MDU-C2/Butler/report/title.tex

% title.tex	

\begin{center}

	\begin{figure}[t]	
		
	\end{figure}
    \Large M\"{a}lardalen University \\
    \Large School of Innovation, Design and Engineering \\
    \Large V\"{a}ster\r{a}s, Sweden\\

    \noindent\makebox[\linewidth]{\rule{\textwidth}{0.4pt}}\\
    [0.5cm]
                
    \Large{Project Course in Robotics and Embedded Systems,\\
    CDT508 and DVA425}\\
    [2.0cm]

	\huge \textbf{\uppercase{The Butler Project}} \\ 
    [1.85cm] 
				
    \begin{tabular}{@{}ll}
    
		\Large Examiner: & 
		\begin{minipage}[t]{0,7\textwidth}
		    \Large Mikael Ekstr\"om\\
		    \large M\"{a}lardalen University, 
		    \large V\"{a}ster\r{a}s, Sweden\\ 
		\end{minipage}\\
		[0.5cm]
			
		\Large Project Manager: & 
		\begin{minipage}[t]{0,7\textwidth}
		    \Large Henrik Falk\\
		    \large M\"{a}lardalen University, 
		    \large V\"{a}ster\r{a}s, Sweden 
		\end{minipage}\\
		[0.5cm]
		
	    \Large Editors: &
	    \begin{minipage}[t]{0,7\textwidth}
	    \Large Niclas Holmqvist \\
	    \Large Armantal Hasanbegovic \\
	    \Large Martin Johansson\\
	    \Large Anders Persson\\
	    \large M\"{a}lardalen University,
	    \large V\"{a}ster\r{a}s, Sweden
	    \end{minipage}\\
	    \\
		\Large Research Partners: & 
		\begin{minipage}[t]{0,7\textwidth}
            % \large Mälardalen University\\
            % \large Volvo CE\\
            % \large Husqvarna\\
            % \vspace{0.01ex}
            
		    
		    
		    
        \end{minipage}\\
        \\
        \vspace{1.5ex}
        \Large Sponsors: & 
        \begin{minipage}[t]{0,7\textwidth}
            % \large Aratron\\
            % \large Rollco\\
            % \large W\"urth Electronics\\
            % \large Avans\\
            % \large Mekanex\\
            % \vspace{0.000001ex}
            \hspace{-0.5em}
		    
		    
		    
            
        
        \end{minipage}
    
    \end{tabular}
    
    \vspace*{\fill}
    \large \today
    
\end{center}
