MDU-C2/Butler/report/Appendices/appendices1.tex

\section{Trajectory Overview - Niclas Holmqvist}
\label{app:urdf}

\rotatebox{90}{
\begin{minipage}{0.95\textheight}
    
    \captionof{figure}{The different frames of the Butler URDF}
    \label{urdf}
\end{minipage}
}

%%\section{Trajectory Output}
%%\label{app:traj}
\begin{figure}[!ht]
\centering
    
    \caption{A few examples of the joint space trajectory message generated by the MoveIt package. The vectors contain data for each joint of the robot butler arm as [base plate rotation, elevator, shoulder, elbow]}
    \label{traj_ex}
\end{figure}

\clearpage

\section{Project Summary - Henrik Falk}
\label{appendix:summary}
\input{./Introduction/project_management}
