MDU-C2/Butler/report/Vision/vision.tex

\section{Vision - Albin B}
\subsection{Point Cloud}
\subsection{Visual Odometry}
