MDU-C2/Butler/report/Introduction/project_management.tex

%\section{Project Summarisation (might not be included or put here) - Henrik Falk}

\begin{table}[h]
\centering
\begin{tabular}{lll}
\hline
\textbf{Department} & \textbf{Intended Use} & \textbf{SEK} \\ \hline
    Mechanics      &    Materials       &         4000  \\
    Electronics      &      Components     &           9000\\
    AI/Nav/Control      &       Processing Unit    &           6800\\
    Signal-/Image-processing      &     Camera, Communication      &           2500\\
\textbf{Total spent} & \textbf{} & \textbf{22300} \\ \hline
\end{tabular}
\caption{Total spending for the Butler Project 2017.}
\label{table:spending}
\end{table}

\begin{figure}[h]
    \centering
    
    \caption{The chart illustrates the reported amount of time spent per day as well as average per person per day for the project. Over 4000 hours have been put in on the Butler Project 2017.}
    \label{fig:tpdb}
\end{figure}

In Figure \ref{fig:tpdb}, the work effort is illustrated with data from the time log. You can se tendencies within in the progress of the project by analysing the time reported by the members. The introductory period is quite apparent until around the beginning of September. The big dips, e.g. 23rd of September, is reported overtime. The 4th of November to the 11th of November illustrates the period from ordering parts to delivery. Observe the big increase of hours from the 14th of November and to the 10th of December where all the parts would arrive at the same time and most of the work that needed to be done could continue.
