MDU-C2/Butler/butler5/urdf/butler5.pdf

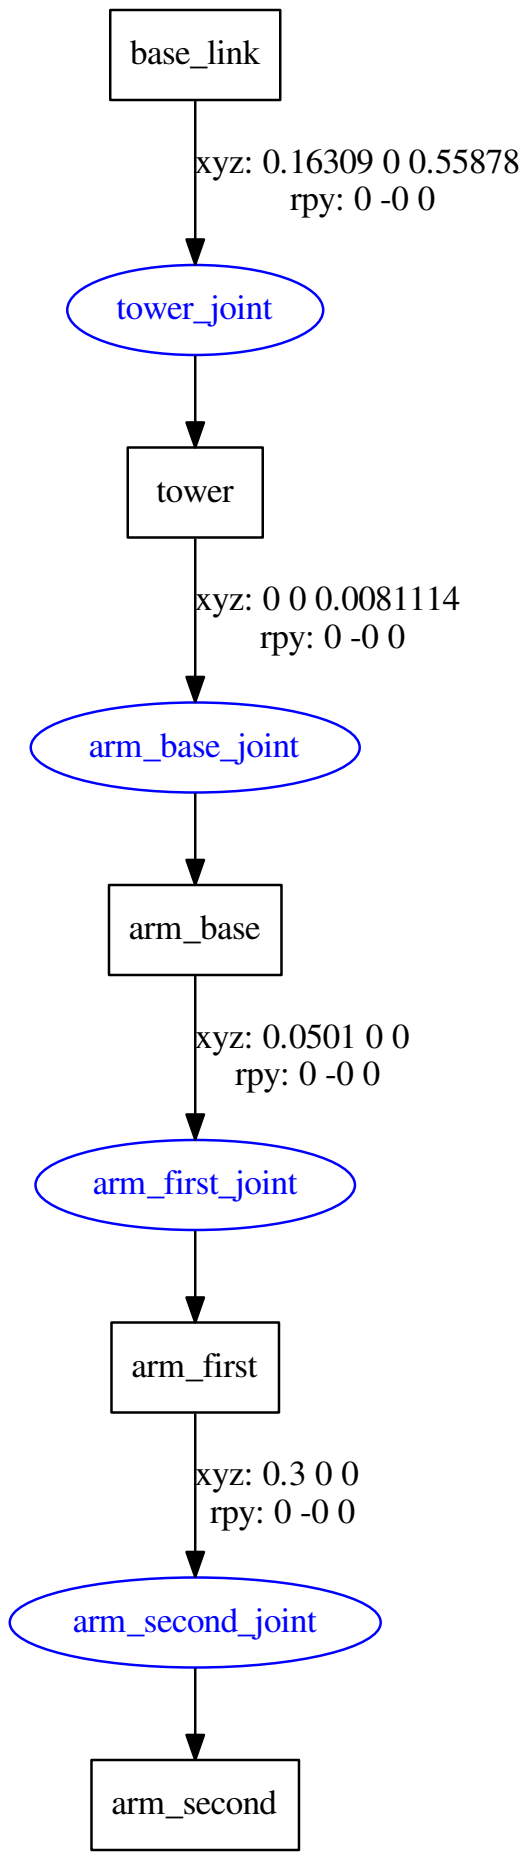
[picture p1: figure]
base_link; tower_joint; xyz: 0.16309 0 0.55878 rpy: 0 -0 0; tower; arm_base_joint; xyz: 0 0 0.0081114 rpy: 0 -0 0; arm_base; arm_first_joint; xyz: 0.0501 0 0 rpy: 0 -0 0; arm_first; arm_second_joint; xyz: 0.3 0 0 rpy: 0 -0 0; arm_second
