MDU-C2/Butler/butler5/meshes/left_wheel.STL

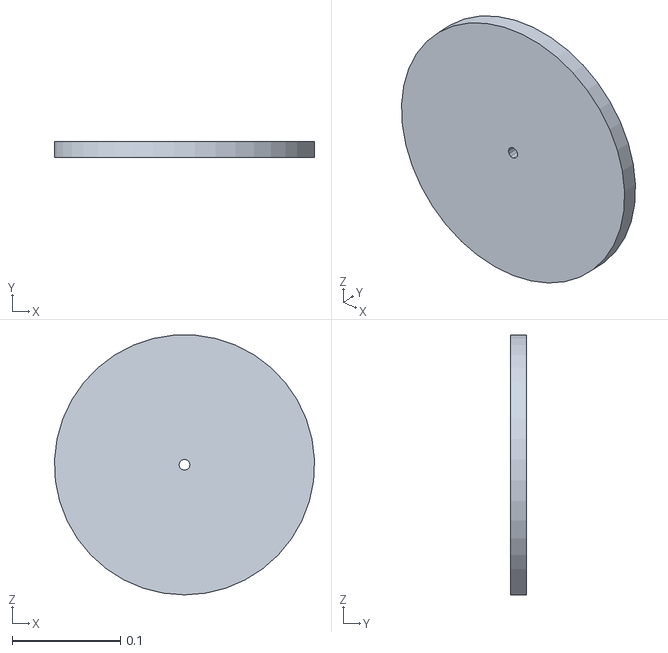
[picture p2: CAD file, 2017-11-17]
butler5/meshes/left_wheel.STL
0.24 x 0.015 x 0.24
