MDU-C2/Butler/butler5/meshes/tower.STL

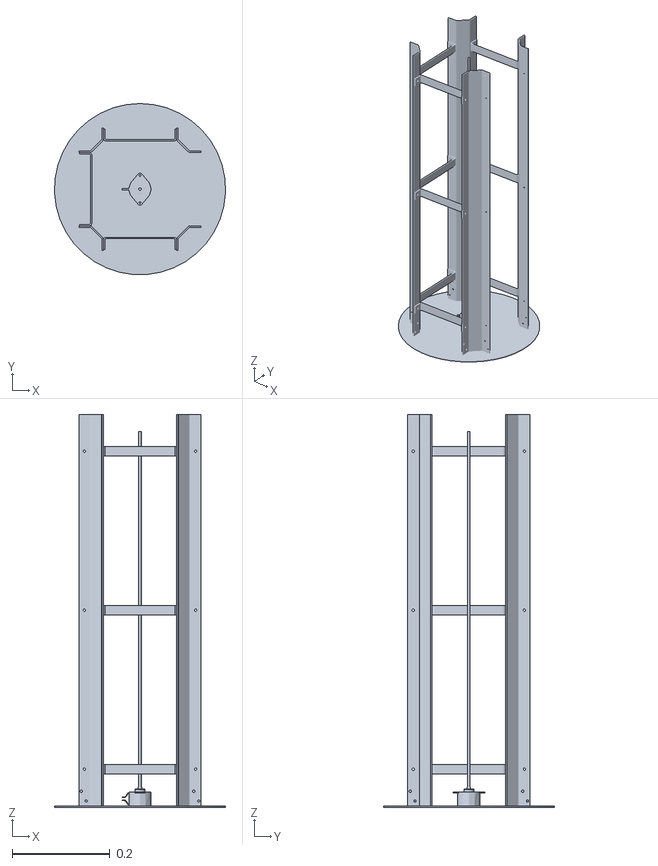
[picture p3: CAD file, 2017-11-17]
butler5/meshes/tower.STL
0.35 x 0.349 x 0.803
