MDU-C2/Butler/butler5/meshes/arm_base.STL

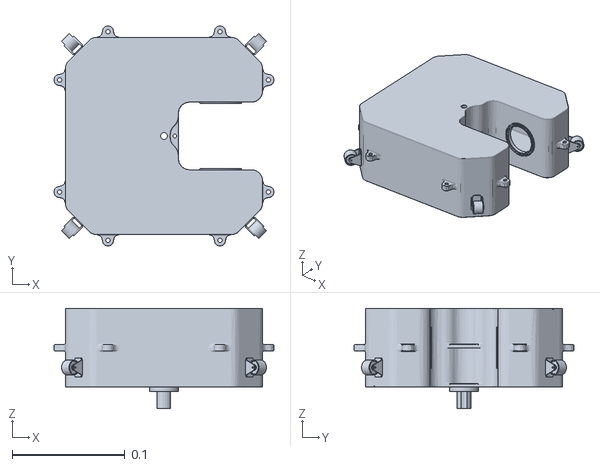
[picture p4: CAD file, 2017-11-17]
butler5/meshes/arm_base.STL
0.195 x 0.195 x 0.089
