MDU-C2/Butler/butler5/meshes/arm_first.STL

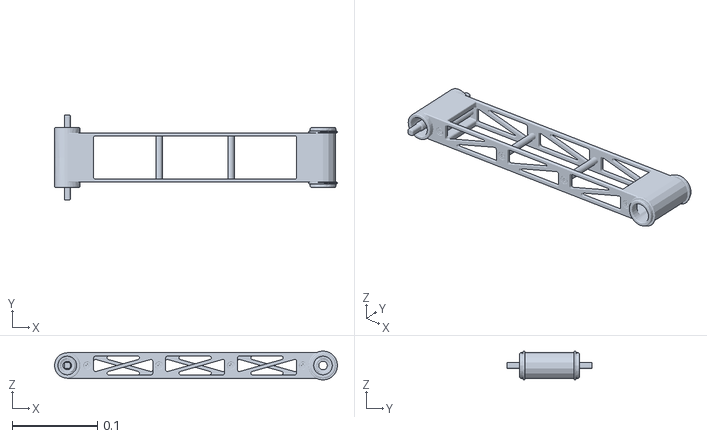
[picture p5: CAD file, 2017-11-17]
butler5/meshes/arm_first.STL
0.332 x 0.1 x 0.034
