MDU-C2/Butler/butler5/meshes/base_link.STL

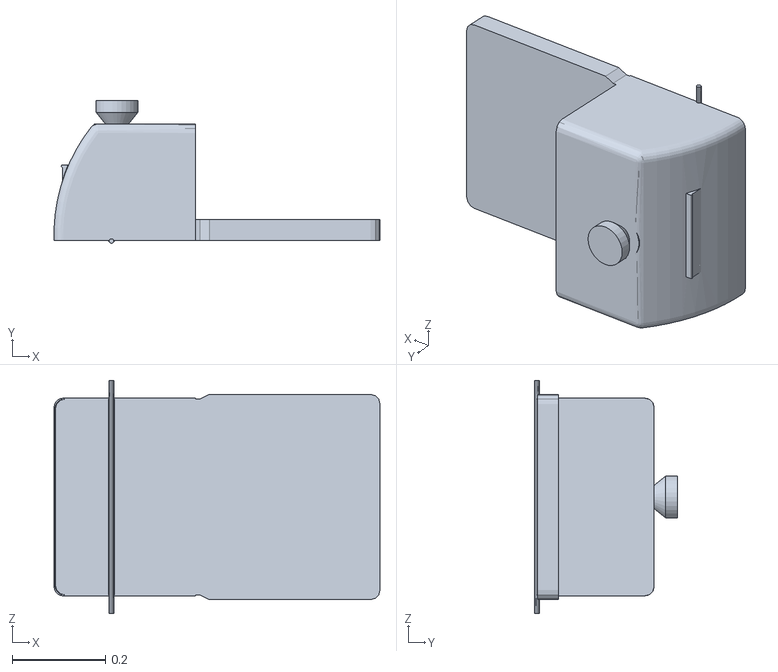
[picture p6: CAD file, 2017-11-17]
butler5/meshes/base_link.STL
0.699 x 0.306 x 0.5
