MDU-C2/Butler/butler5/meshes/arm_second.STL

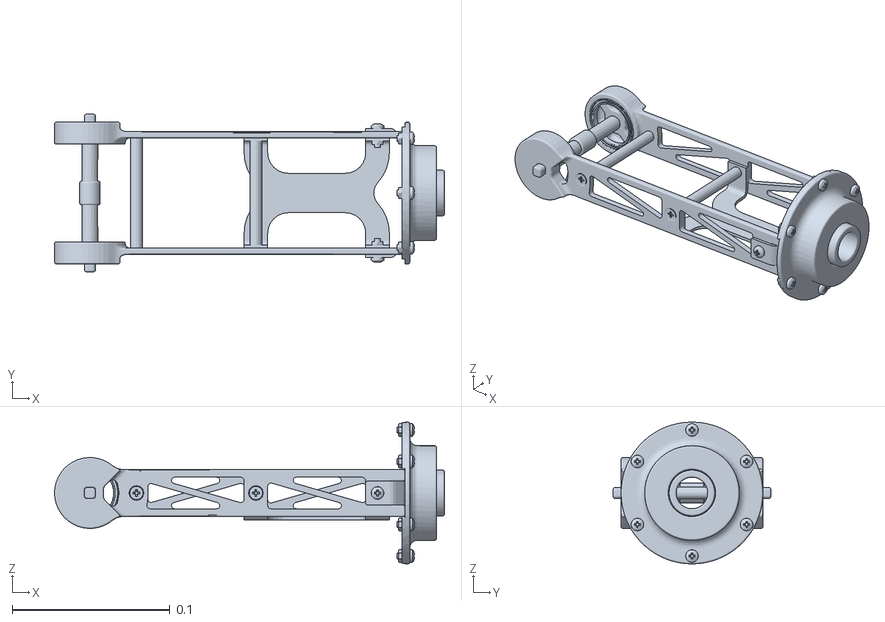
[picture p7: CAD file, 2017-11-17]
butler5/meshes/arm_second.STL
0.247 x 0.1 x 0.0899
