MDU-C2/Butler/butler5/meshes/base_link_old.STL

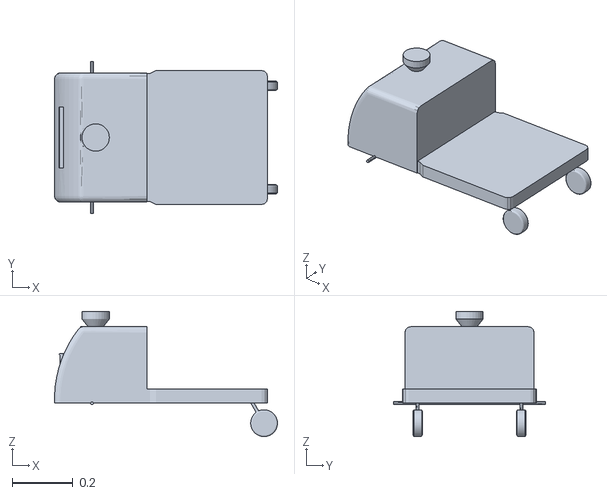
[picture p8: CAD file, 2017-11-17, an earlier design]
butler5/meshes/base_link_old.STL
0.732 x 0.5 x 0.411
