MDU-C2/Butler/(list of files, cad)

Other CAD files:
butler5/meshes/right_wheel.STL
