MDU-C2/Butler/butler5/urdf/swivel_wheel.urdf.xacro

<?xml version="1.0"?>
<robot name="swivel_wheel" xmlns:xacro="http://www.ros.org/wiki/xacro">
 
  <!-- Wheels -->
<!--
  <property name="wheel_radius" value="0.125" /> 
  <property name="wheel_height" value="0.032" />
-->
  <property name="wheel_mass" value="0.5" /> <!-- in kg-->
 
<!--
  <property name="base_x_origin_to_wheel_origin" value="0.25" />
  <property name="base_y_origin_to_wheel_origin" value="0.3" />
  <property name="base_z_origin_to_wheel_origin" value="0.0" />
-->
 
  <macro name="cylinder_inertia" params="m r h">
    <inertia ixx="${m*(3*r*r+h*h)/12}" ixy = "0" ixz = "0" iyy="${m*(3*r*r+h*h)/12}" iyz = "0" izz="${m*r*r/2}" /> 
  </macro>
 
  <macro name = "swivel_arm" params="lr index l offset">
    <link name="sw_arm_${lr}_${index}">
      
      <inertial>
        <mass value="0.01" />
        <origin xyz="0 0 0" />
        <cylinder_inertia m="0.01" r="0.004" h="${l}" />
      </inertial>

      <visual>
        <geometry>
        <cylinder radius="0.004" length="${l}"/>
        </geometry>
        <material name="silver">
         <color rgba="0.3 0.3 0.3 1"/>
        </material>  
        <origin rpy="0 0 0" xyz="${offset}" />
      </visual>
    </link>
  </macro>
 
  <xacro:macro name="swivel_wheel" params="fb lr parent translateX translateY translateZ wheel_radius wheel_height flip"> <!--fb : front, back ; lr: left, right -->

    <!-- First link connected to parent-->
    <swivel_arm lr = "${lr}" index = "1" l = "0.06" offset="0 0 -0.03"/>
    
    <joint name="sw_arm_${lr}_connect_1" type="continuous">
      <origin xyz="${translateX} ${translateY} ${translateZ}" rpy="0 0 0" /> 
      <axis xyz="0 0 1" rpy="0 0 0" />
      <parent link="${parent}"/>
      <child link="sw_arm_${lr}_1"/>
      <limit effort="100" velocity="100"/>
      <joint_properties damping="0.0" friction="0.0"/>
    </joint> 
      
    <!-- Second link connected to first--> 
    <swivel_arm lr = "${lr}" index = "2" l = "0.04" offset="0 0 0.02"/>
      
    <joint name="sw_arm_${lr}_connect_2" type="fixed">
      <origin rpy="1.5707 0 0" xyz="0 0 -0.06" />
      <parent link="sw_arm_${lr}_1"/>
      <child link="sw_arm_${lr}_2"/>
    </joint>
    
    <!-- Third link connected to second--> 
    <swivel_arm lr = "${lr}" index = "3" l = "0.06" offset="0 0 -0.03"/>
      
    <joint name="sw_arm_${lr}_connect_3" type="fixed">
      <origin rpy="-1.5707 0 -0.78" xyz="0 0 0.04" />
      <parent link="sw_arm_${lr}_2"/>
      <child link="sw_arm_${lr}_3"/>
    </joint>
    
    <!-- Fourth link connected to third--> 
    <swivel_arm lr = "${lr}" index = "4" l = "0.04" offset="0 0 -0.02"/>
    
    <joint name="sw_arm_${lr}_connect_4" type="fixed">
      <origin rpy="1.5707 0 0" xyz="0 0 -0.060" />
      <parent link="sw_arm_${lr}_3"/>
      <child link="sw_arm_${lr}_4"/>
    </joint>

    <!-- Wheel connected to fourth--> 
    <link name="${fb}_${lr}_swivel_wheel">
      <visual>
        <origin xyz="0 0 0" rpy="${flip*M_PI/2} 0 0" /> 
        <geometry>
          <cylinder length="${wheel_height}" radius="${wheel_radius}" />
        </geometry>
        <material name="Black" />
      </visual>
      <collision>
        <origin xyz="0 0 0" rpy="0 0 0" />
        <geometry>
          <cylinder length="${wheel_height}" radius="${wheel_radius}" />
        </geometry>
      </collision>
      <inertial>
        <mass value="${wheel_mass}" />
        <origin xyz="0 0 0" />
        <cylinder_inertia m="${wheel_mass}" r="${wheel_radius}" h="${wheel_height}" />
      </inertial>
    </link>
 
    <gazebo reference="${fb}_${lr}_swivel_wheel">
      <mu1 value="0.8"/>
      <mu2 value="0.8"/>
      <kp value="10000000.0" />
      <kd value="1.0" />
      <fdir1 value="1 0 0"/>
      <material>Gazebo/Black</material>
      <turnGravityOff>false</turnGravityOff>
    </gazebo>
 
    <joint name="${fb}_${lr}_swivel_wheel_joint" type="continuous">
      <parent link="sw_arm_${lr}_4"/>
      <child link="${fb}_${lr}_swivel_wheel"/>
      <origin rpy="0 0 0" xyz="0 0 -0.04" />
      <axis xyz="0 0 1" rpy="0 0 0" />
      <limit effort="100" velocity="100"/>
      <joint_properties damping="0.0" friction="0.0"/>
    </joint>
 

    
    <!-- Transmission is important to link the joints and the controller -->

    <transmission name="${fb}_${lr}_swivel_wheel_joint_trans">
      <type>transmission_interface/SimpleTransmission</type>
      <joint name="${fb}_${lr}_swivel_wheel_joint">
        <hardwareInterface>EffortJointInterface</hardwareInterface>
      </joint>
      <actuator name="${fb}_${lr}_swivel_wheel_joint_motor">
        <hardwareInterface>EffortJointInterface</hardwareInterface>
        <mechanicalReduction>1</mechanicalReduction>
      </actuator>
    </transmission>


 
  </xacro:macro>
</robot>
