MDU-C2/Butler/report/Electronics/bulterpdb.pdf

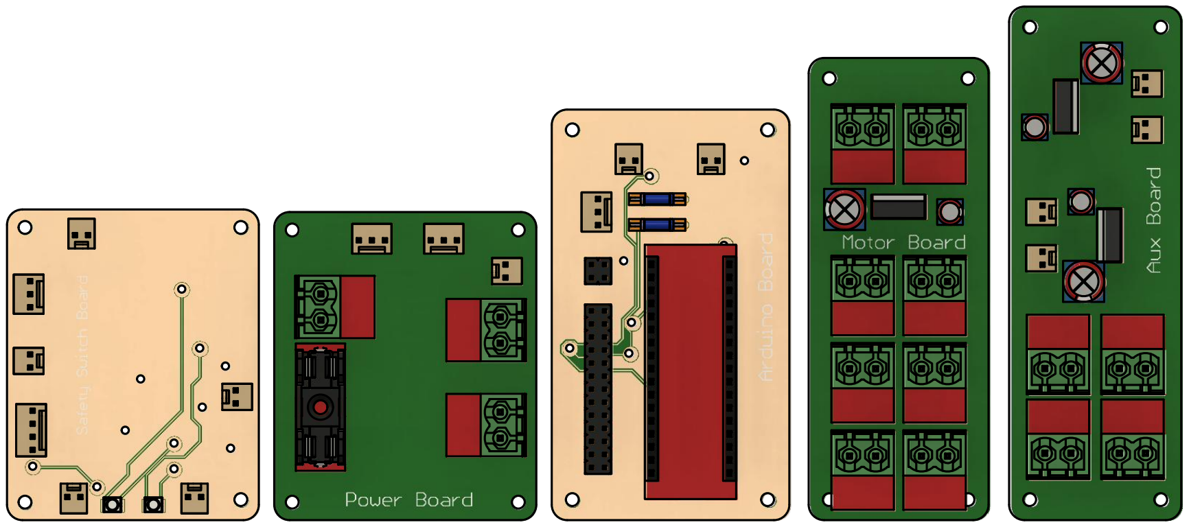
[picture p9: page 1]
