MDU-C2/Butler/(commit log)

2017-11-23 darknet properly added, configs to come
    [tiny-yolo-voc.cfg, tiny-yolo.cfg, yolo-voc.cfg, yolo.cfg, yolo9000.cfg]
2017-11-24 object detector action result callback routine and object detection configs added
    [butler_cups.cfg]
2017-11-30 ros_control till boilerplate
    [butler_controllers (copy).yaml, butler_controllers.yaml]
2017-11-30 skjut en bäver
    [butler_controllers (copy).yaml, butler_controllers.yaml]
2017-12-08 launch file for object detector
    [butler_tiny.cfg]
2018-01-14 Create Motor Controller and CAN
    Motor controller code for the MCU ( EK-TM4C123GXL)
